alibelli/EE464_term_project_Social_Isiolation/Flyback_converter_AHS/Thermal analiz.png

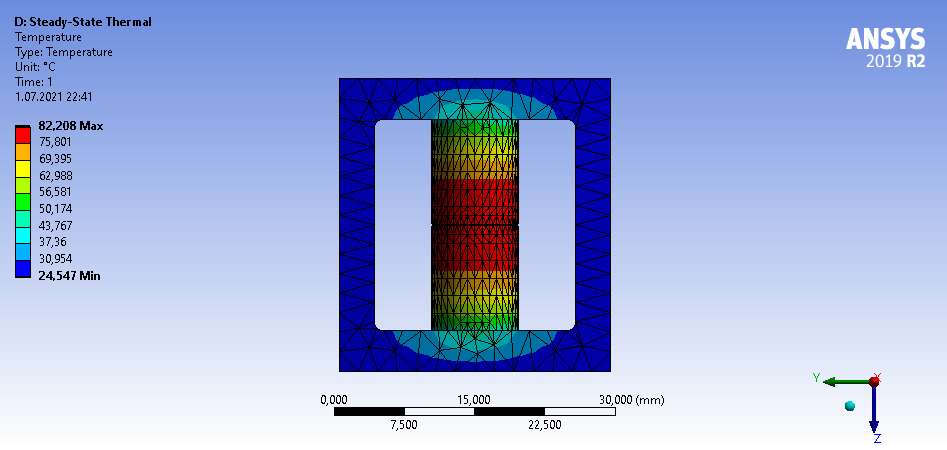
Flyback_converter_AHS/Thermal analiz.png
