alibelli/EE464_term_project_Social_Isiolation/README.md

# EE464_term_project_Social_Isolation
Term project work of Berkay Uzun, Ahmet Halis Sabırlı and Ali Belli.
