alibelli/EE464_term_project_Social_Isiolation/Flyback_converter_AHS/Losses.docx

MOSFET:

P_(sw) =E_(sw) *f=5.2*10^(-6) *150*10^3 =0.78 W

P_(conduction) =I_(D,RMS)^2 *R_(DS) =0.827^2 *0.280=0.19 W

T_j =P_(loss) *R_(tiJA) +25°=(0.78+0.19)*45+25°=68.65°

Diode:

P_(conduction) =I*V_(on) =11.94*0.56=6.69 W

T_j =P_(loss) *R_(tiJL) +25°=6.69*10+25°=91.9°

Transformer:

P_(cu) =P_(cu,pri) +P_(cu,sec) =I_(pri,RMS)^2 *R_(pri,AC) +I_(sec,RMS)^2 *R_(sec,AC)

P_(cu) =0.833^2 *1.87+12.04^2 *0.042=7.39 W

Core loss is calculated from online calculator offered by TDK.

P_(core) =11.89 W

Snubber:

P_(Snubber) =P_(diode) +P_(resistor) =2.16+6.35=8.51 W

T_j =P_(loss) *R_(tiJA) +25°=2.16*24+25°=76.84°
