alibelli/EE464_term_project_Social_Isiolation/Flyback_converter_AHS/Sunum.pptx

Social Isolation Inc.
Berkay UZUN - 2263812
Ali BELLİ - 2231421
Ahmet Halis SABIRLI – 2305225

## TABLE OF CONTENTS

- Topology and Controller Selection
- Transformer Design
- Component Selection and Simulation Results
- Cost Analysis

## Topology Selection

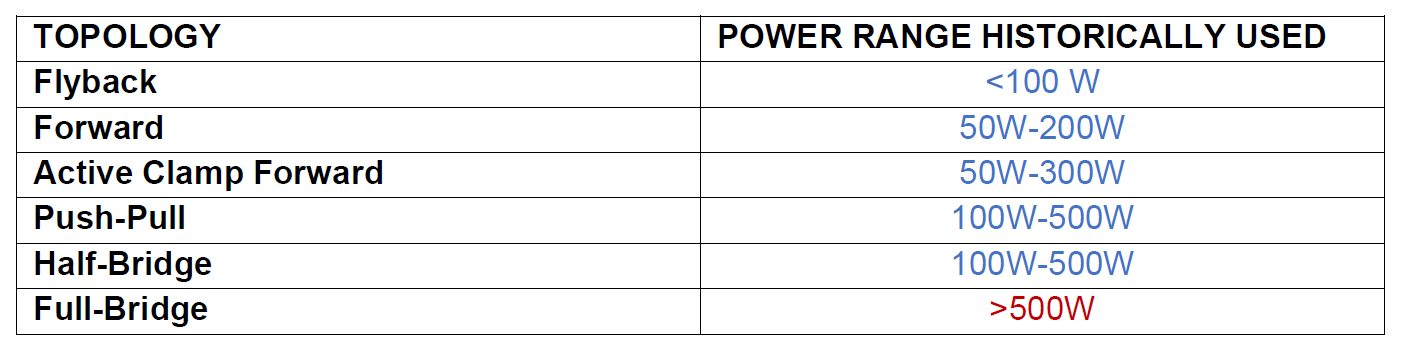
[picture p36: figure]

## Topology Selection

## Controller Selection

LT3752 LT8316

## Transformer Design

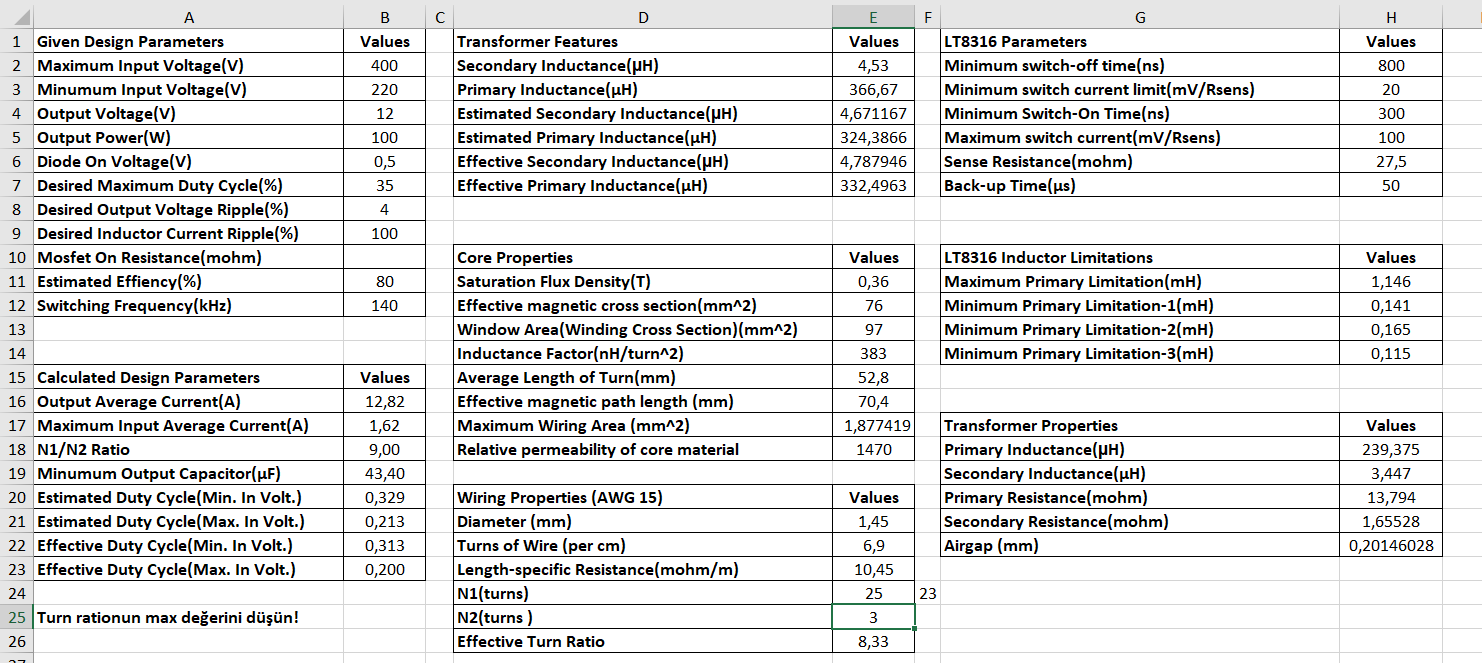
[picture p37: figure]

## Transformer Design

Selected Core

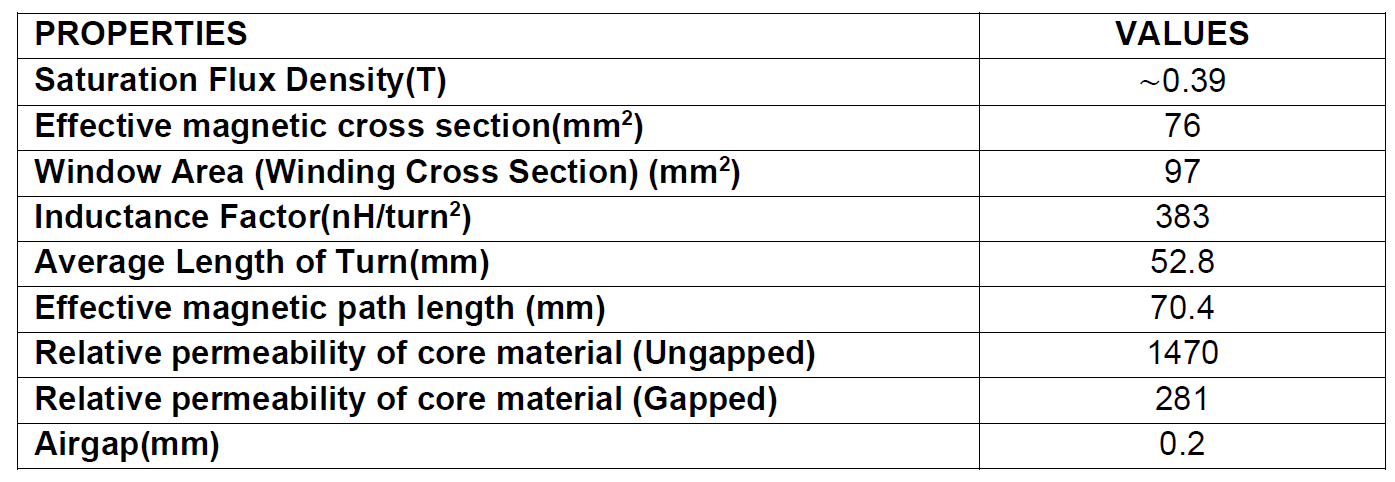
[picture p38: figure]

## Finite Element Analysis

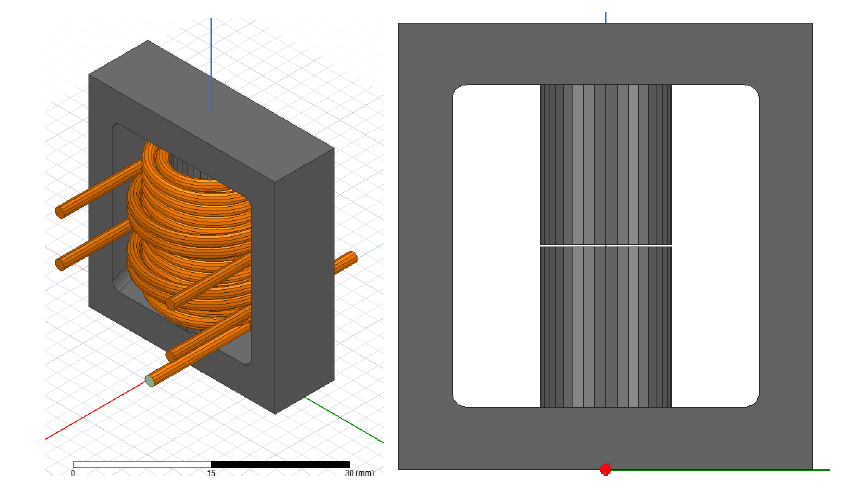
[picture p39: figure]

## Finite Element Analysis

## Finite Element Analysis

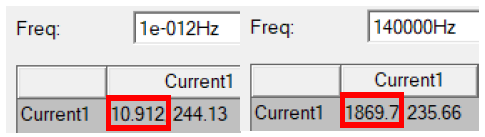
[picture p40: figure]

## Component Selection

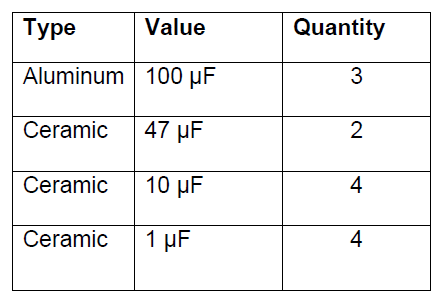
[picture p41: figure]

## MOSFET Voltage and Current

## Sense and Feedback Resistor Selection

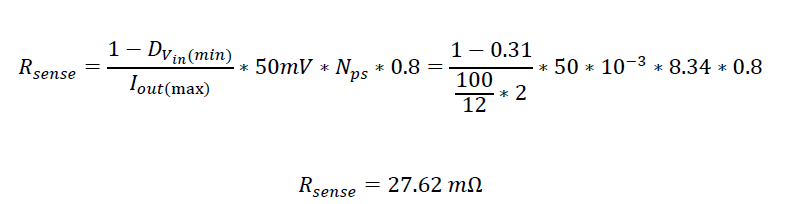
[picture p42: figure]

## Project Design Schematic

## Simulation Results

400V input

## Simulation Results

220V input

## Load Regulation

## Load Regulation

## Line Regulation

## Line Regulation

## Cost Analysis

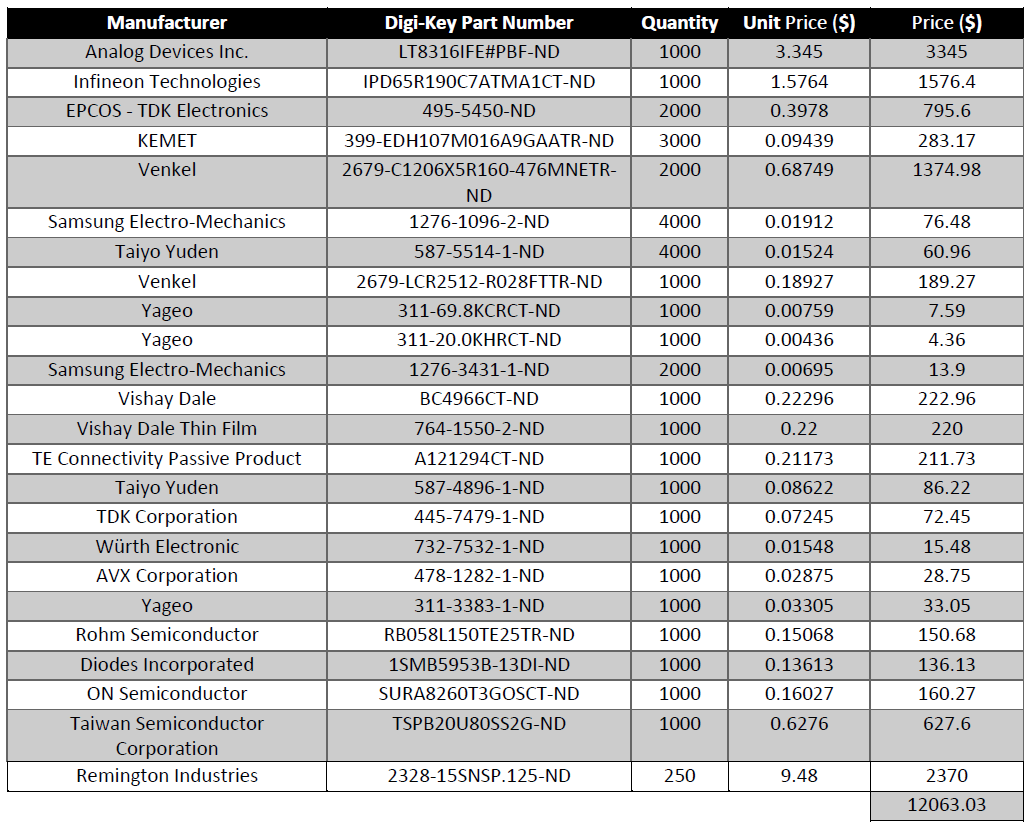
[picture p43: figure]

## Slide 22

Thank You
