alibelli/EE464_term_project_Social_Isiolation/Flyback_converter_AB/Transformer_Design.xlsx

Given Design Parameters | Values | Transformer Features | Values |  | LT8316 Parameters | Values
Maximum Input Voltage(V) | 400 | Secondary Inductance(µH) | 4.53 |  | Minimum switch-off time(ns) | 800
Minumum Input Voltage(V) | 220 | Primary Inductance(µH) | 366.67 |  | Minimum switch current limit(mV/Rsens) | 20
Output Voltage(V) | 12 | Estimated Secondary Inductance(µH) | 4.671167247 |  | Minimum Switch-On Time(ns) | 300
Output Power(W) | 100 | Estimated Primary Inductance(µH) | 324.3866144 |  | Maximum switch current(mV/Rsens) | 100
Diode On Voltage(V) | 0.5 | Effective Secondary Inductance(µH) | 4.787946429 |  | Sense Resistance(mohm) | 27.5
Desired Maximum Duty Cycle(%) | 35 | Effective Primary Inductance(µH) | 332.4962798 |  | Back-up Time(µs) | 50
Desired Output Voltage Ripple(%) | 4
Desired Inductor Current Ripple(%) | 100
Mosfet On Resistance(mohm) |  | Core Properties | Values |  | LT8316 Inductor Limitations | Values
Estimated Effiency(%) | 80 | Saturation Flux Density(T) | 0.36 |  | Maximum Primary Limitation(mH) | 1.146
Switching Frequency(kHz) | 140 | Effective magnetic cross section(mm^2) | 76 |  | Minimum Primary Limitation-1(mH) | 0.141
 |  | Window Area(Winding Cross Section)(mm^2) | 97 |  | Minimum Primary Limitation-2(mH) | 0.165
 |  | Inductance Factor(nH/turn^2) | 383 |  | Minimum Primary Limitation-3(mH) | 0.115
Calculated Design Parameters | Values | Average Length of Turn(mm) | 52.8
Output Average Current(A) | 12.82 | Effective magnetic path length (mm) | 70.4
Maximum Input Average Current(A) | 1.62 | Maximum Wiring Area (mm^2) | 1.877419355 |  | Transformer Properties | Values
N1/N2 Ratio | 9.00 | Relative permeability of core material | 1470 |  | Primary Inductance(µH) | 239.375
Minumum Output Capacitor(µF) | 43.40 |  |  |  | Secondary Inductance(µH) | 3.447
Estimated Duty Cycle(Min. In Volt.) | 0.329 | Wiring Properties (AWG 15) | Values |  | Primary Resistance(mohm) | 13.794
Estimated Duty Cycle(Max. In Volt.) | 0.213 | Diameter (mm) | 1.45 |  | Secondary Resistance(mohm) | 1.65528
Effective Duty Cycle(Min. In Volt.) | 0.312 | Turns of Wire (per cm) | 6.9 |  | Airgap (mm) | 0.2014602796
Effective Duty Cycle(Max. In Volt.) | 0.200 | Length-specific Resistance(mohm/m) | 10.45
 |  | N1(turns) | 25 | 23
Turn rationun max değerini düşün! |  | N2(turns ) | 3
 |  | Effective Turn Ratio | 8.33
