alibelli/EE464_term_project_Social_Isiolation/Flyback_converter_AB/100W_12V_flyback.docx

Flyback topology:

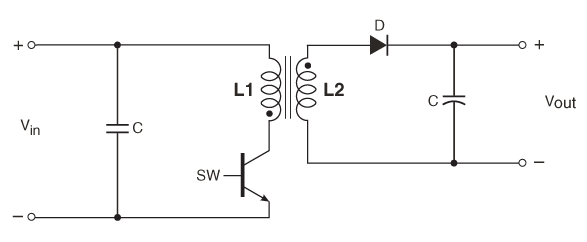
[picture p71: figure]
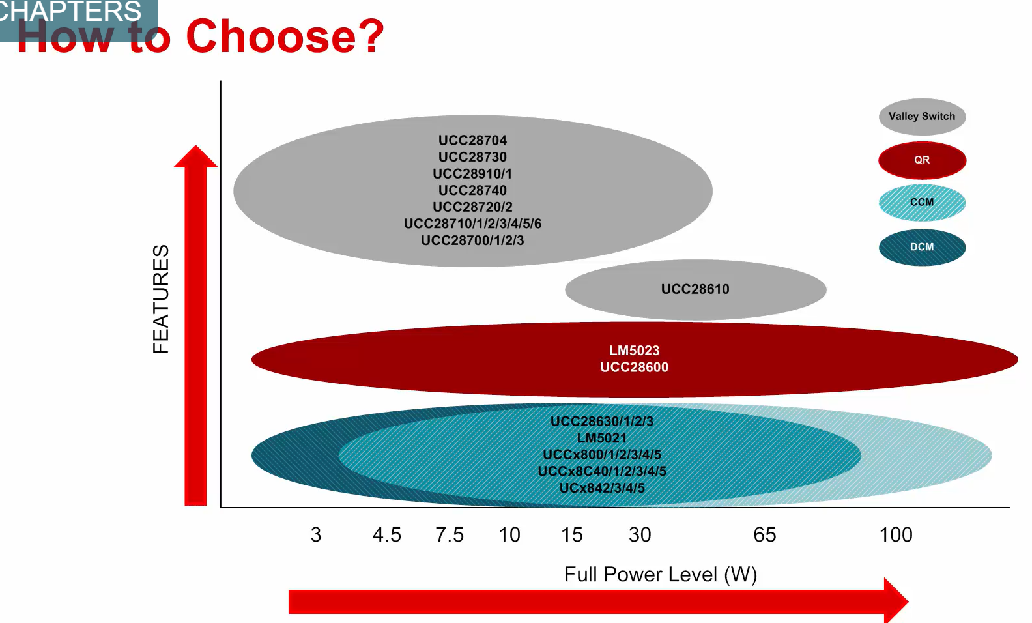
[picture p72: figure]
