alibelli/EE464_term_project_Social_Isiolation/Bom_V3.xlsx

Sheet: My Lists Worksheet
Index | Manufacturer Name | Quantity | Digi-Key Part Number | Unit Price($) | Price($)
1 | Analog Devices Inc. | 1000 | LT8316IFE#PBF-ND | 3.68 | 3679.50
2 | EPCOS - TDK Electronics | 2000 | 495-5450-ND | 0.43 | 855.42
3 | KEMET | 3000 | 399-EDH107M016A9GAATR-ND | 0.09 | 283.17
4 | Venkel | 2000 | 2679-C1206X5R160-476MNETR-ND | 0.69 | 1374.98
5 | Samsung Electro-Mechanics | 7000 | 1276-1096-2-ND | 0.02 | 133.84
6 | Taiyo Yuden | 4000 | 587-5514-1-ND | 0.02 | 60.96
7 | Venkel | 1000 | 2679-LCR2512-R028FTTR-ND | 0.19 | 189.27
8 | Yageo | 1000 | 311-69.8KCRCT-ND | 0.01 | 7.59
9 | Yageo | 1000 | 311-20.0KHRCT-ND | 0.00436 | 4.36
10 | Samsung Electro-Mechanics | 2000 | 1276-3431-1-ND | 0.01 | 19.40
11 | Vishay Dale | 1000 | BC4966CT-ND | 0.15 | 148.12
12 | Vishay Dale Thin Film | 1000 | 764-1550-2-ND | 0.22 | 220.00
13 | TE Connectivity Passive Product | 1000 | A121294CT-ND | 0.21 | 211.73
14 | Taiyo Yuden | 1000 | 587-4896-1-ND | 0.09 | 86.22
15 | TDK Corporation | 1000 | 445-7479-1-ND | 0.07 | 72.45
16 | Würth Elektronik | 3000 | 732-7532-1-ND | 0.02 | 46.44
17 | AVX Corporation | 1000 | 478-1282-1-ND | 0.03 | 28.81
18 | Yageo | 1000 | 311-3383-1-ND | 0.03 | 33.05
19 | Rohm Semiconductor | 1000 | RB058L150TE25TR-ND | 0.15 | 150.68
20 | Diodes Incorporated | 1000 | 1SMB5953B-13DI-ND | 0.14 | 136.13
21 | Taiwan Semiconductor Corporation | 1000 | TSPB20U80SS2G-ND | 0.63 | 627.60
22 | ON Semiconductor | 1000 | SURA8260T3GOSCT-ND | 0.16 | 160.27
23 | Delta Electronics/Cyntec | 1000 | 2037-RL1632T4F-R001-FNHCT-ND | 0.18 | 179.44
24 | IXYS | 1000 | IXTA10P50P-TRLTR-ND | 4.27 | 4273.39
25 | Diodes Incorporated | 1000 | DDZ9697DICT-ND | 0.06 | 56.10
26 | Stackpole Electronics Inc | 2000 | RMCF0402FT100RCT-ND | 0.00274 | 5.48
27 | KOA Speer Electronics, Inc. | 1000 | 2019-RN73H1ETTP4931B25CT-ND | 0.10 | 105.00
28 | KOA Speer Electronics, Inc. | 1000 | 2019-RN73H1ETTP3121D50CT-ND | 0.08 | 78.40
29 | SMC Diode Solutions | 2000 | 1655-1N4007FLCT-ND | 0.03 | 61.38
30 | KOA Speer Electronics, Inc. | 1000 | 2019-RN73H1ETTP8871F50CT-ND | 0.08 | 78.40
31 | Bourns Inc. | 1000 | CR0402-JW-753GLFCT-ND | 0.0035 | 3.50
32 | Vishay Dale | 1000 | 541-RCS040230K0FKEDCT-ND | 0.02 | 17.71
33 | Nichicon | 1000 | 493-6711-2-ND | 0.39 | 394.96
34 | Samtec Inc. | 4000 | SAM10770-ND | 0.42 | 1680.64
35 | Vishay Dale | 1000 | 541-3971-1-ND | 0.01 | 6.10
36 | Yageo | 2000 | 13-AF0402JR-071KLCT-ND | 0.01 | 13.10
37 | Vishay Dale | 1000 | 541-4715-1-ND | 0.01 | 6.10
38 | TE Connectivity Passive Product | 1000 | A116024CT-ND | 0.17 | 169.96
39 | Analog Devices Inc. | 1000 | LT6107HS5#TRMPBFTR-ND | 1.96 | 1963.50
40 | Texas Instruments | 1000 | LMH6618MK/NOPBTR-ND | 2.38 | 2378.25
41 | Maxim Integrated | 1000 | LM4041CIM3-1.2+TCT-ND | 3.17 | 3165.00
42 | Diodes Incorporated | 1000 | DMN26D0UDJ-7DICT-ND | 0.12 | 118.80
43 | Texas Instruments | 1000 | 296-49459-2-ND | 3.53 | 3533.25
44 | Infineon Technologies | 1000 | IPD80R280P7ATMA1CT-ND | 1.89 | 1888.20
44 | PCBWay | 1000 | PCB | 0.45 | 450.00
 |  |  |  | TOTAL COST | 29156.65

Sheet: Sayfa1
3.6795
0.42771
0.09439
0.68749
0.01912
0.01524
0.18927
0.00759
0.00436
0.0097
0.14812
0.22
0.21173
0.08622
0.07245
0.01548
0.02881
0.03305
0.15068
0.13613
0.6276
0.16027
0.17944
4.27339
0.0561
0.00274
0.105
0.0784
0.03069
0.0784
0.0035
0.01771
0.39496
0.42016
0.0061
0.00655
0.0061
0.16996
1.9635
2.37825
3.165
0.1188
3.53325
1.8882
