alibelli/EE464_term_project_Social_Isiolation/Flyback_converter_AHS/reverse voltage.asc

C1: cap; 2.7µ
D1: zener; BZX84C10L
M1: pmos; IRF9640
R1: res; 100k
R2: res; 1600
R3: res; 30
V1: voltage; PULSE(-400 400 0.5 1n 1n 1)
Named nets: 0, Vin, Vout
.tran 0 0.6 0.4
