alibelli/EE464_term_project_Social_Isiolation/Flyback_converter_AHS/8316.asc

C1: cap; 4.7µ
C2: cap; 400p; Rser=100
C3: cap; 47p; Rser=10K
C5: cap; 4.7µ
C8: cap; 470µ; Rser=3m
C9: cap; 100n; Rser=20K
D1: schottky; RBR10NS60A
D2: schottky; RB058L150
D3: diode; RFN1L7S
D4: zener; 1N5378B; N=2
L1: ind2; 244.11µ; Rser=1.87
L2: ind2; 3.55µ; Rser=42.6m Cpar=0.5p
L3: ind2; 3.55µ; Rser=42.6m
R1: res; 1k
R4: res; 500k
R5: res; 92k
R6: res; 10k
R9: res; 61.9K
Rload: res; 0.44
Rsense: res; 27.5m
S1: sw
U1: LT8316
U3: IPD65R190C7_L0
V1: voltage; PULSE(5 5 150m 1u 0 0 1)
Vin: voltage; PULSE(220 400 10m 1u 0 0 1)
Named nets: 0, IN, OUT
K1 L1 L2 L3 0.99
8:1:1
.tran 0 250m 0 startup
.lib C:\\Users\\ahmet\\OneDrive\\Belgeler\\LTspiceXVII\\lib\\sub\\CoolMos2.lib
.model SW SW()
