alibelli/EE464_term_project_Social_Isiolation/(list of files, drawings)

Other design files:
PCB/PCB_Project/Control.SchDoc
PCB/PCB_Project/PCB1.PcbDoc
PCB/PCB_Project/PCB_Project.PrjPcb
PCB/PCB_Project/PcbLib1.PcbLib
PCB/PCB_Project/Power.SchDoc
PCB/PCB_Project/Schlib1.SchLib
