alibelli/EE464_term_project_Social_Isiolation/(commit log)

2021-04-25 Transformer design according to AN of LT8316
    [Transformer.xlsx]
2021-04-25 Uptadet verion of transformar calculation
    [Transformer_Design.xlsx]
2021-04-25 LTspice model
    [Transformer.xlsx, Transformer_Design.xlsx]
2021-04-30 Bill of Materials
    [Bom_8624738.xlsx]
2021-04-30 BOM updated
    [Bom_8624738.xlsx]
2021-04-30 Component selection and report were updated.
    [Bom_8624738.xlsx]
2021-06-30 reverse voltage protection
2021-06-30 Reverse voltage protection yazı
2021-07-01 PCB of the project has designed both with schematic and the layout.
    [Control.SchDoc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]
2021-07-01 Protection circuits were added.
2021-07-02 PCB description and the appendix for it.
2021-07-02 Final report and table of cost analysis were updated.
    [Bom_V3.xlsx]
